themangoest/QUAN/Capture d'écran 2025-05-20 103528.png

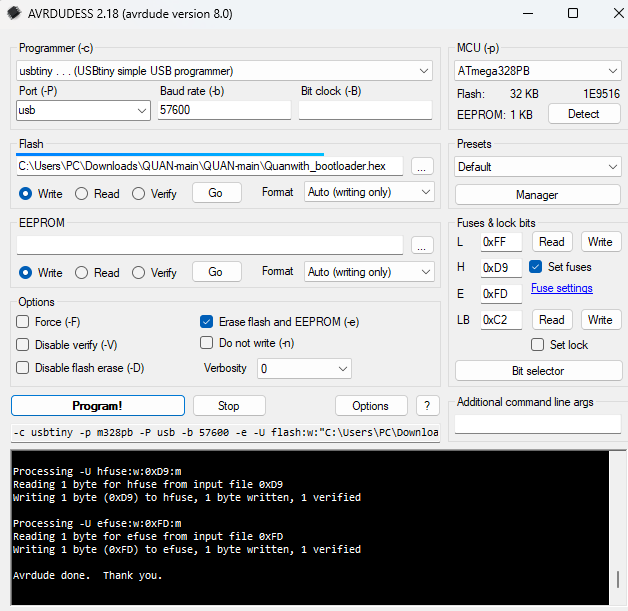
Capture d'écran 2025-05-20 103528.png
