themangoest/QUAN/prototype mod.png

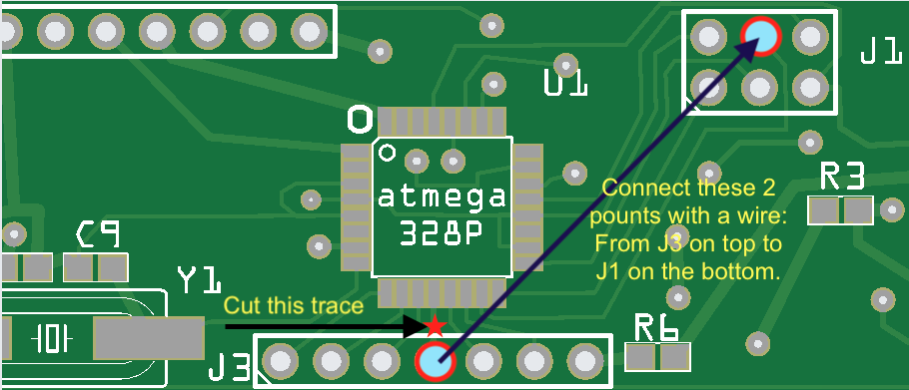
prototype mod.png
