themangoest/QUAN/QUAN.png

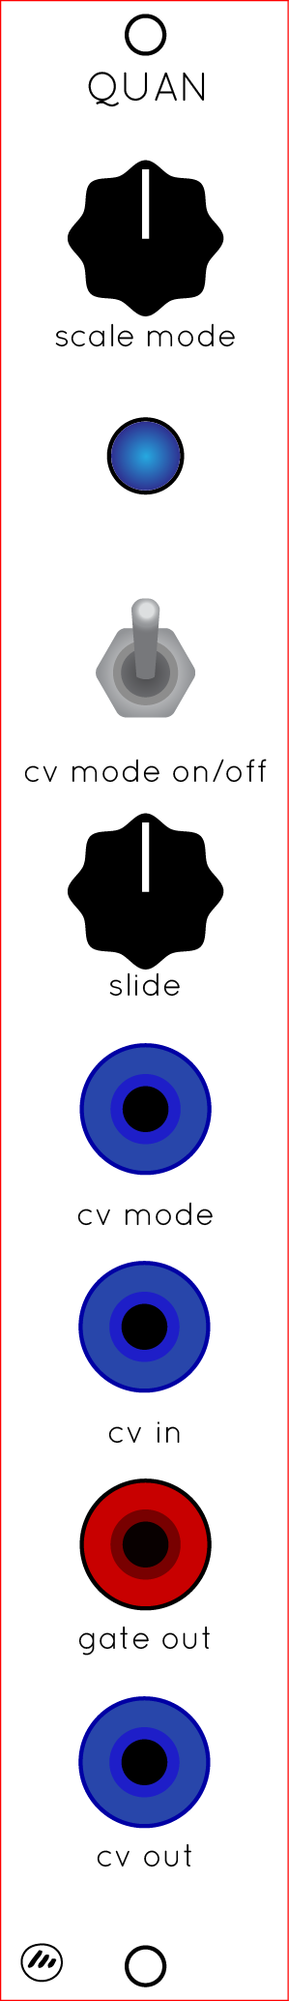
QUAN.png
